OldSurferDude/Interface-board-for-remote-control/AC201-15A remote control 06 pcb close up annotated.jpg

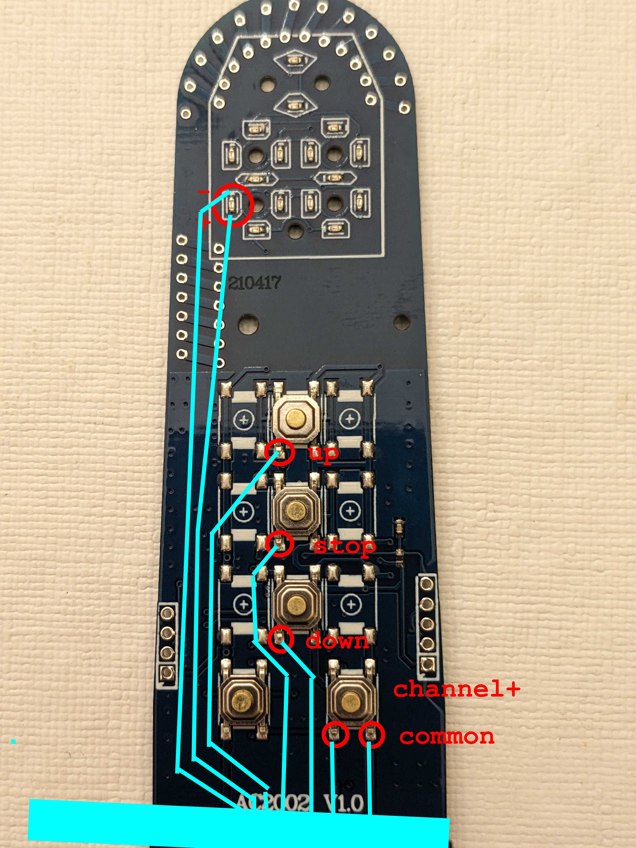
AC201-15A remote control 06 pcb close up annotated.jpg
