OldSurferDude/Interface-board-for-remote-control/AC201-15A remote control 04 back removed annotated.jpg

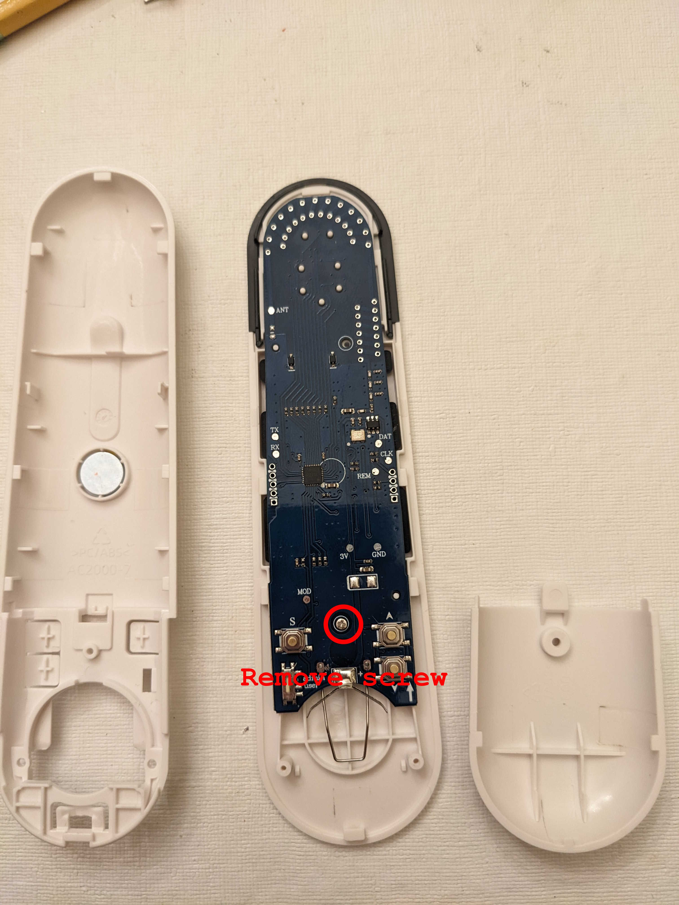
AC201-15A remote control 04 back removed annotated.jpg
