OldSurferDude/Interface-board-for-remote-control/AC201-15A remote control 03 battery compartment door removed annotated.jpg

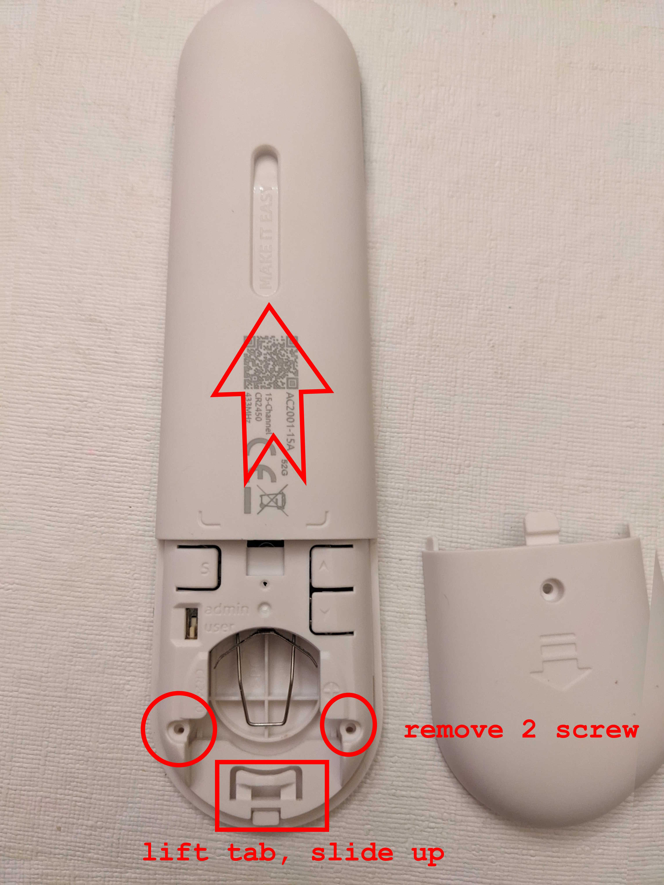
AC201-15A remote control 03 battery compartment door removed annotated.jpg
