OldSurferDude/Interface-board-for-remote-control/BlindsController schematic.pdf

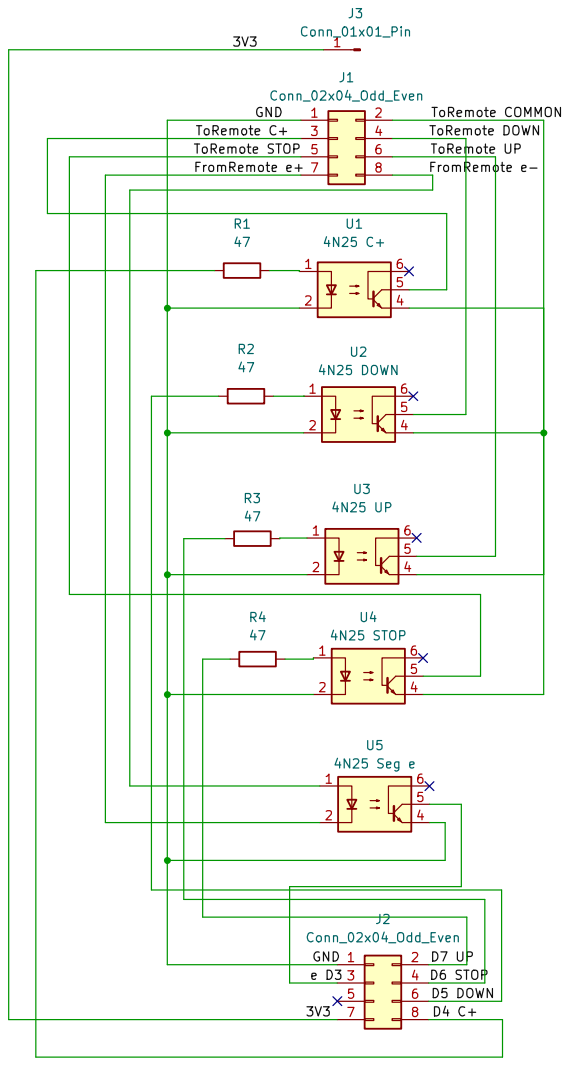
[picture p10: page 1]
