OldSurferDude/Interface-board-for-remote-control/(notices)

Notices in the files:
README.md:
ky/S6K1Bb9DL6imJy490ooQrS/LuKIoBDgm0k0D8EY7xKFuTOVBpTPY4OdaU6XTig0iXozmRNynheC7jQLYyqotRFISH/Hn7xjUWe9db7MPyNRssN23ZrhCx3rXezIbSTvHC6sAWu32bbfeitdbbd/Gpl9OVE1+/p6f4C/CXMT3rJUIwMJGqimxzBA4atw3qHKxLLyaN6LpJdggRaIUpgsKk3mtmZXdXqGdyZXyNtjrVO9XzvCngcl6YfUteJNrRr1KacRSkeFHnDWq9blh+7VaDp2RkB14nKrmfU4EWOOpy
